KaedeAsatsuki/Nirvana/Type-SS/pcb/nirvana-pt1/nirvana-pt1.kicad_pcb

## KiCad design Type-SS/pcb/nirvana-pt1/nirvana-pt1.kicad_pcb (2019-02-01)

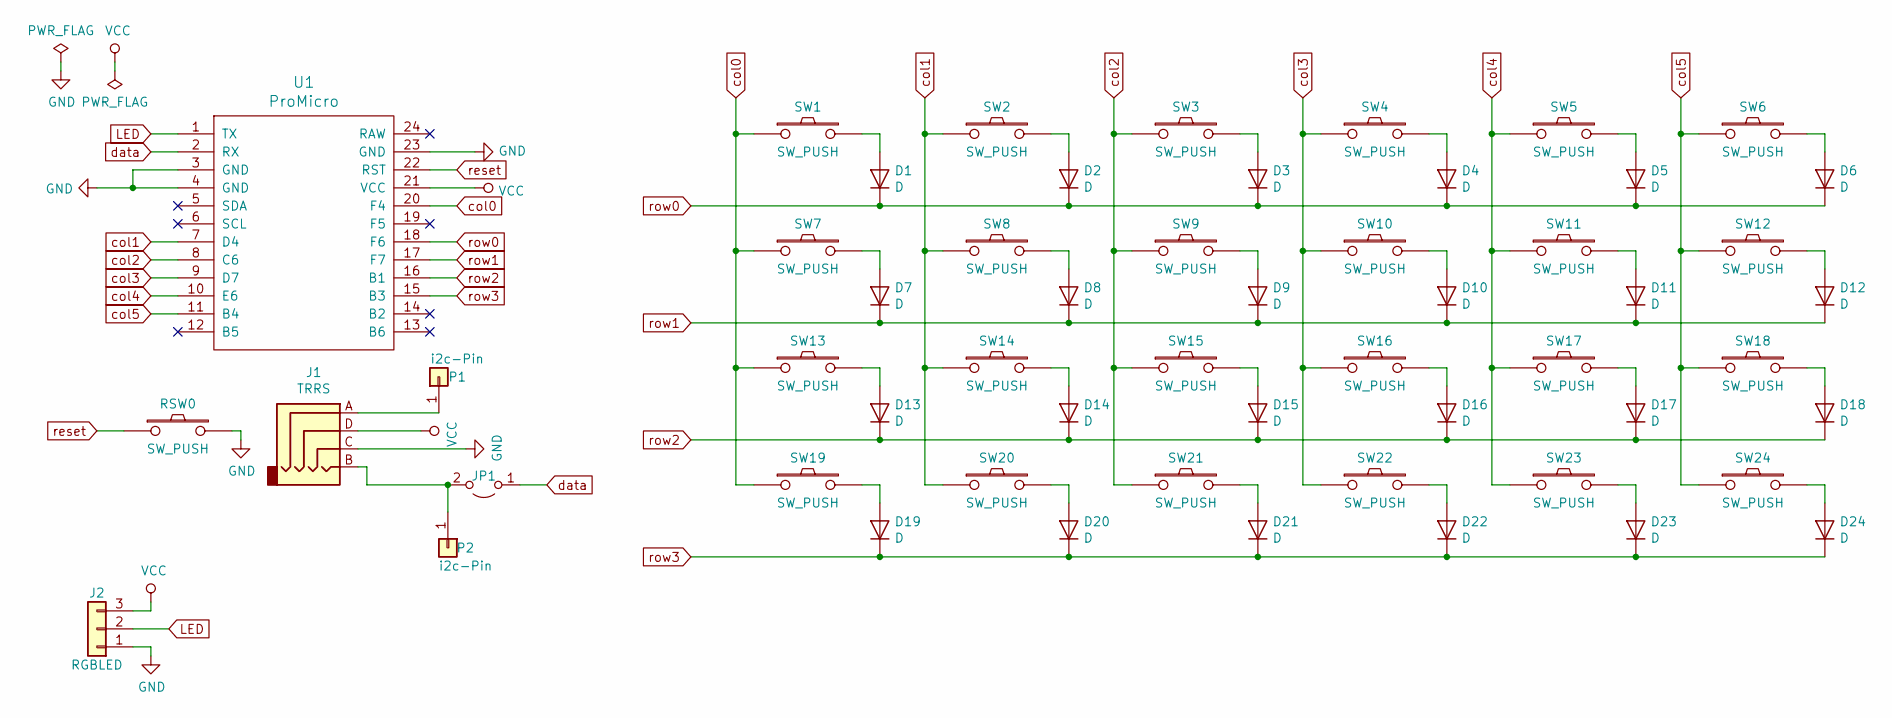
[picture p1: schematic nirvana-pt1.sch, Nirvana pt-1]

Parts:
D1, D2, D3, D4, D5, D6, D7, D8, D9, D10, D11, D12, D13, D14, D15, D16, D17, D18, D19, D20, D21, D22, D23, D24: D; D_SMD_re
J1: TRRS; MJ-4PP-9
J2: RGBLED; StripLED_rev
JP1: Jumper_2_Open; SolderJumper-2_P1.3mm_Open_RoundedPad1.0x1.5mm
P1, P2: i2c-Pin; 1pin_conn
RSW0: SW_PUSH; ResetSW
SW1, SW2, SW3, SW4, SW5, SW6, SW7, SW8, SW9, SW10, SW11, SW12, SW13, SW14, SW15, SW16, SW17, SW18, SW21, SW22, SW23, SW24: SW_PUSH; MX_ALPS_PG1350_noLed
SW19, SW20: SW_PUSH; MX_ALPS_PG1350_noLed_1.75u
U1: ProMicro; ProMicro_v2

Connections:
GND: J1.C, J2.1, RSW0.2, U1.3 (GND), U1.4 (GND), U1.23 (GND)
LED: J2.2, U1.1 (TX)
unnamed: D1.2 (A), SW1.2
unnamed: D2.2 (A), SW2.2
unnamed: D3.2 (A), SW3.2
unnamed: D4.2 (A), SW4.2
unnamed: D5.2 (A), SW5.2
unnamed: D6.2 (A), SW6.2
unnamed: D7.2 (A), SW7.2
unnamed: D8.2 (A), SW8.2
unnamed: D9.2 (A), SW9.2
unnamed: D10.2 (A), SW10.2
unnamed: D11.2 (A), SW11.2
unnamed: D12.2 (A), SW12.2
unnamed: D13.2 (A), SW13.2
unnamed: D14.2 (A), SW14.2
unnamed: D15.2 (A), SW15.2
unnamed: D16.2 (A), SW16.2
unnamed: D17.2 (A), SW17.2
unnamed: D18.2 (A), SW18.2
unnamed: D19.2 (A), SW19.2
unnamed: D20.2 (A), SW20.2
unnamed: D21.2 (A), SW21.2
unnamed: D22.2 (A), SW22.2
unnamed: D23.2 (A), SW23.2
unnamed: D24.2 (A), SW24.2
unnamed: J1.A, P1.1
unnamed: J1.B, JP1.2 (B), P2.1
VCC: J1.D, J2.3, U1.21 (VCC)
col0: SW1.1, SW7.1, SW13.1, SW19.1, U1.20 (F4)
col1: SW2.1, SW8.1, SW14.1, SW20.1, U1.7 (D4)
col2: SW3.1, SW9.1, SW15.1, SW21.1, U1.8 (C6)
col3: SW4.1, SW10.1, SW16.1, SW22.1, U1.9 (D7)
col4: SW5.1, SW11.1, SW17.1, SW23.1, U1.10 (E6)
col5: SW6.1, SW12.1, SW18.1, SW24.1, U1.11 (B4)
data: JP1.1 (A), U1.2 (RX)
reset: RSW0.1, U1.22 (RST)
row0: D1.1 (K), D2.1 (K), D3.1 (K), D4.1 (K), D5.1 (K), D6.1 (K), U1.18 (F6)
row1: D7.1 (K), D8.1 (K), D9.1 (K), D10.1 (K), D11.1 (K), D12.1 (K), U1.17 (F7)
row2: D13.1 (K), D14.1 (K), D15.1 (K), D16.1 (K), D17.1 (K), D18.1 (K), U1.16 (B1)
row3: D19.1 (K), D20.1 (K), D21.1 (K), D22.1 (K), D23.1 (K), D24.1 (K), U1.15 (B3)

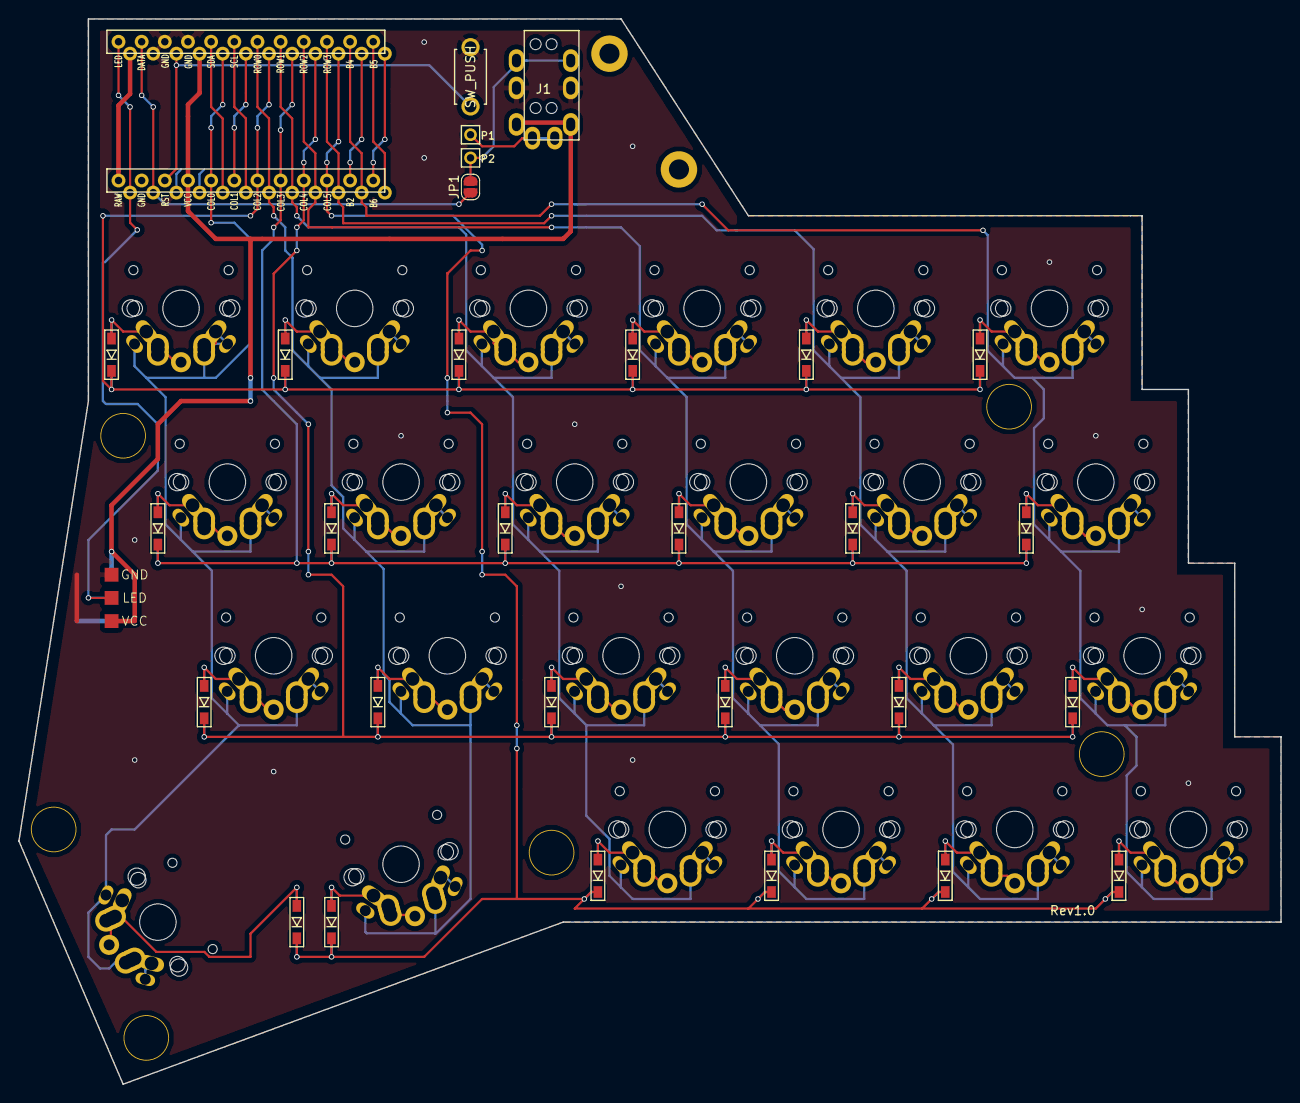
[picture p2: board nirvana-pt1.kicad_pcb from above]

Board: 2 copper layers, 138.4 x 116.8 mm, 55 parts (0 on the bottom side), 41 nets.
