KaedeAsatsuki/Nirvana/(notices)

Notices in the files:
Type-SS/pcb/nirvana-pt1/nirvana-pt1.kicad_pcb:
©Kaede Asatsuki
